MBane04/AnalogPinkNoiseGenerator/simulation/PinkNoise_Transient/pinknoise_transient_testbench.asc

C1: cap; 820p
C2: cap; 10µ
C3: cap; 2.2n
C4: cap; 5.6n
C5: cap; {cdecouple_op}
C6: cap; {cdecouple_op}
C7: cap; 850p
C8: cap; {cdcblock_op}
C9: polcap; 10µ
E1: e; 1
Q1: npn; BC337-16
R1: res; 12k
R2: res; 1Meg
R3: res; 18k
R4: res; 100k
R5: res; {r6_op}
R6: res; {r6_op}
R7: res; {r8_op}
R8: res; 330k
R9: res; 2Meg
R10: res; {rtot_op*(w_op**3.322)}
R11: res; {rtot_op*(1-w_op**3.322)}
R12: res; 100k
R13: res; 10k
U1: opamp2; TL072
U2: opamp2; TL072
V1: voltage; {supply_op}
V2: voltage; {supply_op}
V3: voltage; 0
V4: voltage; 0
V5: voltage; wavefile="white_python.wav" chan=0
Named nets: vout1, 0, vcc_pos, vee_neg, vprenoise, ve_model, vpostnoise, vout2, vout, vout0, ve
.options plotwinsize=0 numdgt=15 measdgt=15
;.op
.tran 0 {tstop} {tstart} {1/fs_op}
;you can opt to save only specific data, such as the output only; comment this out if you want everything saved, but note that 
;the size of the raw file might be quite large, which could negatively affect performance on your machine:
.save V(vout) V(vout2) V(vout1) V(vout0)
;once you have your data, be sure to comment these out or save to a file that you don't care whether or not it gets overwritten
.wave pn_5sec_data.wav 16 50k V(vout)
;.wave pn_5sec_recycle.wav 16 50k V(vout)
Syntax:  .wave <filename.wav> <Nbits>  <SampleRate> V(out) [V(out2) ...]
--> note that .wav file doesn't get generated unless .tran simulation is specified
see this link for more details on .wav files in LTSpice:
https://ltwiki.org/LTspiceHelp/LTspiceHelp/_WAVE_Write_selected_nodes_to_a_wav_file_.htm
; paste your npn model below and be sure to point Q1 to this model
.MODEL BC337-16 NPN(IS=4.887E-14 ISE=2.552f ISC=7.006E-14 XTI=3 BF=207.2 BR=21.85 IKF=0.902 IKR=0.1 XTB=1.5 VAF=184.8 VAR=20 VJE=0.6596 VJC=0.1419 RE=0.119 RC=0.25 RB=50 RBM=2 IRB=0.0002 CJE=4.217E-11 CJC=1.734E-11 XCJC=0.455 FC=0.652 NF=1.002 NR=1.002 NE=1.65 NC=1.25 MJE=0.3434 MJC=0.3484 TF=6E-10 TR=3.5E-08 PTF=86 ITF=0.79 VTF=2.4 XTF=2.1 EG=1.11 VCEO=45 ICRATING=200M MFG=PHILIPS)
+
+
the spice transistor model does not 
support base-emitter reverse breakdown
use this voltage divider
model to set the ve DC
bias voltage instead!
you don't need to build this!
;set cdcblock_op to whatever value you are using for this
.param cdcblock_op=10u
;set rtot_op to whatever total pot resistance you are using
.param rtot_op=40k
;set the pot "wiper" setting below
;.param w_op=0.0500
;.param w_op=0.5000
.param w_op=0.6500
adjust w_op; keep rtot_op fixed!
w_op is the pot "wiper" setting;
higher w_op, higher vout;
w_op constraint: 0 < w_op < 1
that is:
w_op needs to be between 0 and 1,
which means that
w_op cannot be set to exactly 0, 
and
w_op cannot be set to exactly 1
Audio/logarithmic taper Type A potentiometer ("pot");
 
You should choose the total pot resistance to be whatever you 
need it to be;
 
I don't recommend linear taper Type B pots; the pot for this 
project is used for volume control, and Type A is the best choice 
(there are also inverse log taper Type C pots, but I don't recommend 
those, either; stick to audio/log taper Type A pots for the best results!)
 
Note that you should either i) ensure that your Type A pot will fit into your
breadboard holes directly, OR ii) buy some type of adapter that you can
plug your pot into and then plug that adapter into your board, OR iii) be
prepared to solder some wires onto your pot, in this case, I suggest to 
get a pot with solder lugs for the three terminals, fill the solder lug holes 
with solder first, and then reheat and slide the wires in, making sure to 
keep the lengths of your wires manageable (not too long, not too short)
 
Here are some pots (search for Type A on the page, e.g., A10K, etc.) with
solder lug for option iii above:
https://lovemyswitches.com/16mm-potentiometers-1-4-smooth-shaft-solder-lug/
https://lovemyswitches.com/16mm-potentiometers-18t-knurled-shaft-solder-lug/
here, I'm using a unity-gain buffer;
w/o buffer, there is a small amount
of noise that shows up at vprenoise;
may not be an issue, but I thought 
it looked wonky; you don't need to
actually build this, it is for simulation
purposes only
emitter-base junction is reverse biased; 
creates a nice, noisy zener diode;
this is in the open-collector configuration
-->
set parameter ve_op to your target ve value; note that ve=vee_neg+veb,
where veb > 0 is the revese-bias emitter-base voltage of your BJT
details of voltage divider circuit for emulating the bjt circuit:
ve_model = vee_neg + (R8/(R7 + R8))*(vcc_pos - vee_neg)
(ve_model - vee_neg)/(vcc_pos - vee_neg)*(R7 + R8) = R8
alpha*(R7+R8)=R8
R8=alpha*R7/(1-alpha)
place the symbol for the real-world opamp 
you are using here; feel free to move things 
around, but try to keep your schematic neat
consider some kind of non-inverting gain stage; this 
is just a suggestion; feel free to come up with your 
own design; you will need to determine the values of 
any resistors (and caps, if you need those) you need 
in your design; and you need to select an actual, real-
world opamp (DO NOT use the 100Meg model as we 
have done in the past); if you decide to use a non-
inverting gain stage, the south end of the source 
impedance should be tied to ground, not vee_neg
electrolytic decoupling cap
electrolytic decoupling cap
place the symbol for the real-world opamp 
you are using here; feel free to move things 
around, but try to keep your schematic neat
place your pink noise shaping filter design here; you need
to select an actual, real-world opamp (DO NOT use the
100Meg model as we have done in the past); be sure that
all of your resistors and caps have their values shown on
the schematic (this goes for all components in this schematic,
not just the ones for the pink noise shaping filter); you also 
need to determine the DC blocking capacitor value and the
potentiometer resistance in the output stage; the south end
end of the potentiometer in the output stage should be tied 
to ground, not vee_neg
emitter
base
collector
NPN
DC blocking cap
;set supply_op to whatever value you are using for this
.param supply_op=12
;set cdecouple_op to whatever value you are using for this
.param cdecouple_op=100u
;set r6_op to whatever value you are using for this
.param r6_op=100k
;set ve_op to your target ve bias point voltage
.param ve_op=30m
.param alpha={(ve_op+supply_op)/(2*supply_op)}
.param r8_op={(alpha*r6_op)/(1-alpha)}
.param fs_op=50k
.param tstart=1 tstop=6
TO BE CLEAR:
YOU SHOULD NOT BE DESIGNING THE VOLTAGE DIVIDER
OR THE UNITY-GAIN BUFFER MODELS BELOW; THESE ARE
MODELS AND ARE FOR SIMULATION PURPOSES ONLY
this models reverse-biased emitter-base
junction, open-collector npn white noise
note your signal amplitude 
here, e.g., ~1Vp
note your signal amplitude 
here, e.g., ~2.5Vp
consider using the same type of real-world opamp for both 
the gain stage and the pink noise shaping filter; you may 
even be able to find a dual package that has the same two
opamps on one integrated circuit (IC) chip; be sure that any
opamp chips you buy can be placed into a breadboard easily,
and the same goes for your other components, too
* TL072 OPERATIONAL AMPLIFIER "MACROMODEL" SUBCIRCUIT
* CREATED USING PARTS RELEASE 4.01 ON 06/16/89 AT 13:08
* (REV N/A)      SUPPLY VOLTAGE: +/-15V
* CONNECTIONS:   NON-INVERTING INPUT
*                | INVERTING INPUT
*                | | POSITIVE POWER SUPPLY
*                | | | NEGATIVE POWER SUPPLY
*                | | | | OUTPUT
*                | | | | |
.SUBCKT TL072    1 2 3 4 5
*
  C1   11 12 3.498E-12
  C2    6  7 15.00E-12
  DC    5 53 DX
  DE   54  5 DX
  DLP  90 91 DX
  DLN  92 90 DX
  DP    4  3 DX
  EGND 99  0 POLY(2) (3,0) (4,0) 0 .5 .5
  FB    7 99 POLY(5) VB VC VE VLP VLN 0 4.715E6 -5E6 5E6 5E6 -5E6
  GA    6  0 11 12 282.8E-6
  GCM   0  6 10 99 8.942E-9
  ISS   3 10 DC 195.0E-6
  HLIM 90  0 VLIM 1K
  J1   11  2 10 JX
  J2   12  1 10 JX
  R2    6  9 100.0E3
  RD1   4 11 3.536E3
  RD2   4 12 3.536E3
  RO1   8  5 150
  RO2   7 99 150
  RP    3  4 2.143E3
  RSS  10 99 1.026E6
  VB    9  0 DC 0
  VC    3 53 DC 2.200
  VE   54  4 DC 2.200
  VLIM  7  8 DC 0
  VLP  91  0 DC 25
  VLN   0 92 DC 25
.MODEL DX D(IS=800.0E-18)
.MODEL JX PJF(IS=15.00E-12 BETA=270.1E-6 VTO=-1)
.ENDS
