MBane04/AnalogPinkNoiseGenerator/simulation/PinkNoise_AC/pink_noise_shaping_filter_ac.asc

C1: cap; 10µ
C2: cap; 330n
C3: cap; 100n
C4: cap; 33n
C5: cap; 10n
E1: e; 100Meg
R1: res; 10k
R2: res; 3.6k
R3: res; 1k
R4: res; 220
R6: res; 7k
V1: voltage; 0; AC 1 0
Named nets: 0, vout, vin
.ac dec 1000 20 20k
These traces on a dB scale will probably be useful; focus on the magnitude 
response and assume that the phase response is not important for the 
target application space of this project:
 
1) pink noise shaping filter design magnitude response
V(vout)
 
2) ideal magnitude response
G*frequency^-0.5
 
G is a gain parameter that you can set to whatever value gets your two plots
above to overlap well; your main goal here should be to get the slope of your
output magnitude to be "close enough" to the ideal pink noise filter rolloff of
10*log10(1/2) dB/octave, which is about -3.0103 dB/octave (recall that an 
octave is a factor of 2)
 
Don't spend too much time, if any, on picking the "right" value of G; your best
bet is to export the V(vout) ac data to Matlab/Python and perform linear
least-squares (LS) estimation on the slope of the magnitude response of your 
filter; do the LS fitting with dB for the vout magnitude values versus the log10 
of the frequencies; the estimated slope should be "very close" to the ideal 
slope of pink noise (in dB/octave) over the frequency range of interest, i.e., 
the audio band, [20 Hz, 20 kHz]
 
In addition to optimizing the slope of the pink noise shaping filter magnitude 
response (see above), your design should also minimize the maximum error; 
that is, the maximum absolute difference between your linear least-squares fit 
and the simulated magnitude response should be minimized over the audio 
band; you should also assess this in Matlab/Python
PINK NOISE SHAPING FILTER
.options plotwinsize=0 numdgt=15 measdgt=15
ideal
opamp
model
Where to start?
 
If you choose this filter architecture, then you will
design numerical values for all 11 components! 
 
That is, all caps:
C1, C2, C3, C4, C5,
and all resistors:
R1, R2, R3, R4, R5, R6.
 
Since this circuit will be implemented as a discrete
circuit and not on an integrated circuit (IC) chip, you
will need to find feasible, discrete component
values for the various passive components; if you
need a nonstandard component value, consider
constructing what you need from series and/or 
parallel combinations of standard values
 
See the note to the right about ways to improve
this circuit; i.e., adding more feedback shelves,
and/or adding a feedback capacitor; if you make
any additions to this circuit, then you will obviously
need to design values for any additional components
other considerations:
-there are other, similar pink noise shaping filters; this is an 
  idea to get you started
 
-you'll probably want to investigate adding some additional 
  components for improving the performance (see below)
 
-each RC "shelf" is designed to activate at a certain frequency
 
-this architecture has 4 feedback RC shelves and a feedback 
  resistor (and a source RC shelf with R1 and C1)
 
-additional feedback RC shelves can be added (e.g., 6 instead 
  of 4), and a feedback cap in parallel with the feedback resistor
  can also be added; you need to decide what is best
 
-note that the pink noise shaping filter output will drive a series 
  cap followed by a potentiometer in the overall design of your 
  pink noise generator system (not shown here, not needed here)
 
-the input to this filter will come from the output of a gain stage
  (not shown here, not needed here)
 
-the gain stage will receive its input from an NPN BJT in what
  is known as open-collector configuration (not shown here, not
  needed here)
 
-the BJT circuit will provide "white" (a.k.a. gaussian) noise; this
  white noise will be faily low in amplitude, which is what 
  necessitates a gain stage
 
-the ideal opamp in this schematic is good enough to start
  the design of the passive components, but you should also
  investigate practical opamps and decide which ones will work 
  best for your circuit; you will need at least two opamps for
  your overall implementation: one for the pink noise shaping
  filter, and one for the gain stage mentioned above; consider
  getting an IC chip that has multiple opamps on it (and get 
  some spares in case something goes wrong)
 
-this testbench is an AC testbench; no DC considerations will be
  taken into account here (you'll eventually need to consider them)
in the overall system, this input will
come from a gain stage of some kind
(to be deternined by you)
in the overall system, this output will
connect to a cap and a potentiometer
(to be determined by you)
you need to think about ways to improve this circuit!
as it is currently shown, it may not be sufficient!
