MBane04/AnalogPinkNoiseGenerator/(notices)

Notices in the files:
README.md:
License: MIT
